RamiLup/IoT-Refrigerator-Temperature-alarm-prototype/pcb-design/schematic/read.md

You can easily edit this schematic at https://easyeda.com by<br> 
uploading the JSON file to your account.<br>
