RamiLup/IoT-Refrigerator-Temperature-alarm-prototype/images/CAMERA1.jpg

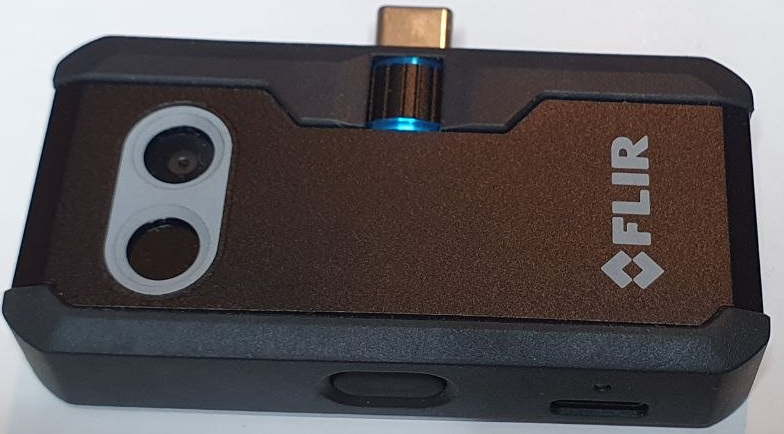
images/CAMERA1.jpg
