RamiLup/IoT-Refrigerator-Temperature-alarm-prototype/images/New_version_pcbs.jpg

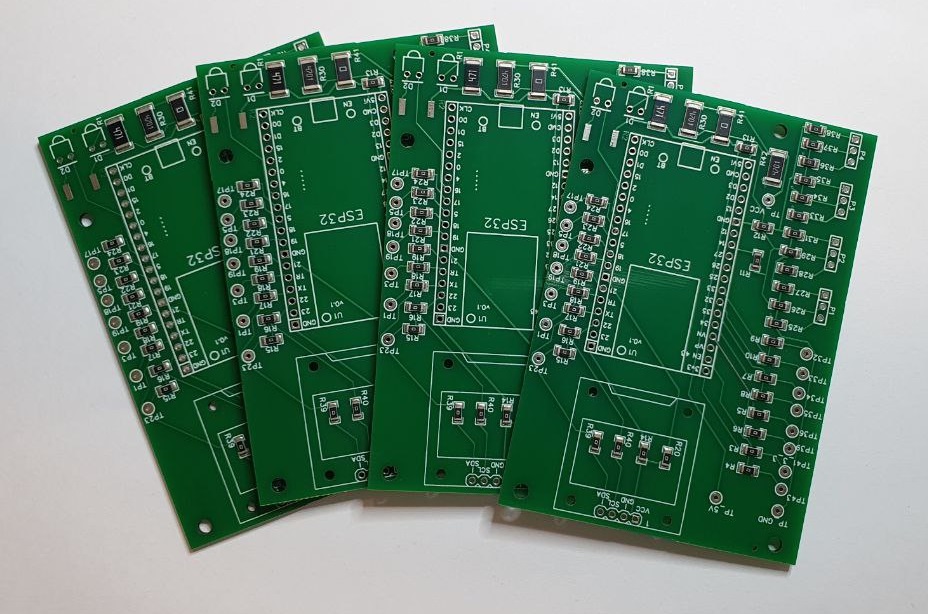
images/New_version_pcbs.jpg
