RamiLup/IoT-Refrigerator-Temperature-alarm-prototype/images/TempInside2.jpg

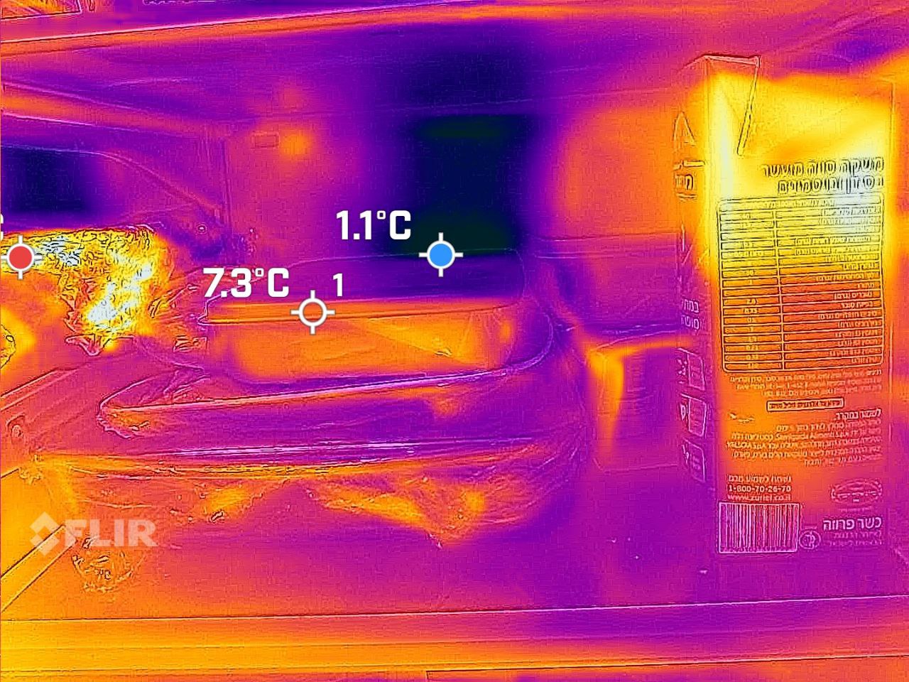
images/TempInside2.jpg
