RamiLup/IoT-Refrigerator-Temperature-alarm-prototype/(list of files, drawings)

Other design files:
pcb-design/schematic/SCH_ESP32_2023-08-31.json
