RamiLup/IoT-Refrigerator-Temperature-alarm-prototype/arduino/secrets.h

// Wifi
#define my_ssid "aaaaaaaaaaaa";
#define my_password "bbbbbbbbbbb";

// Initialize Telegram BOT
#define BOTtokenSecret "cccccccccccccccccccccccccccccccccccccc";
#define CHAT_IDSecret "ddddddddd";
